y2kblog/DCMotorControlShieldV1_0/Hardware/BasePCB_Image.png

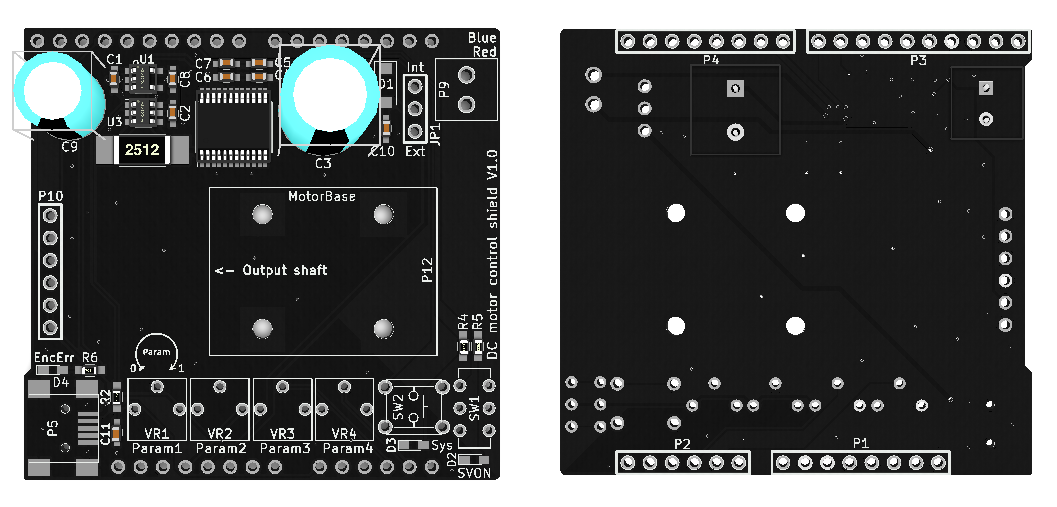
Hardware/BasePCB_Image.png
