y2kblog/DCMotorControlShieldV1_0/Hardware/EncoderPCB_Image.png

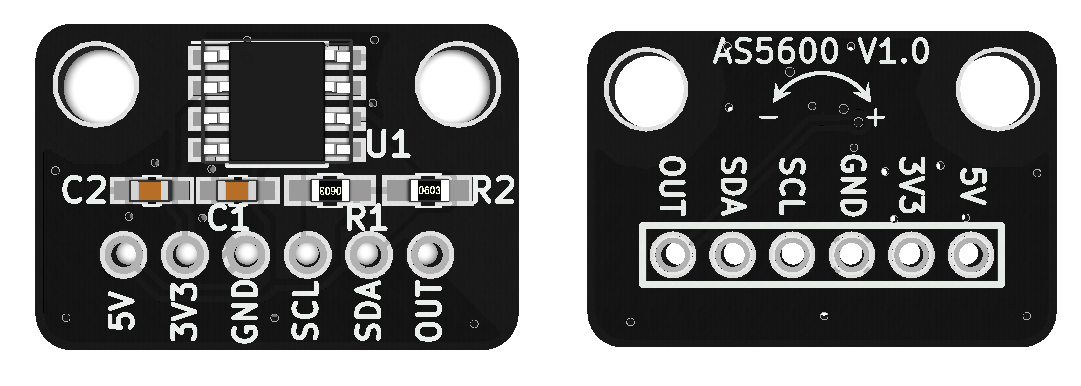
Hardware/EncoderPCB_Image.png
