y2kblog/DCMotorControlShieldV1_0/Hardware/BasePCB_CircuitDiagram.pdf

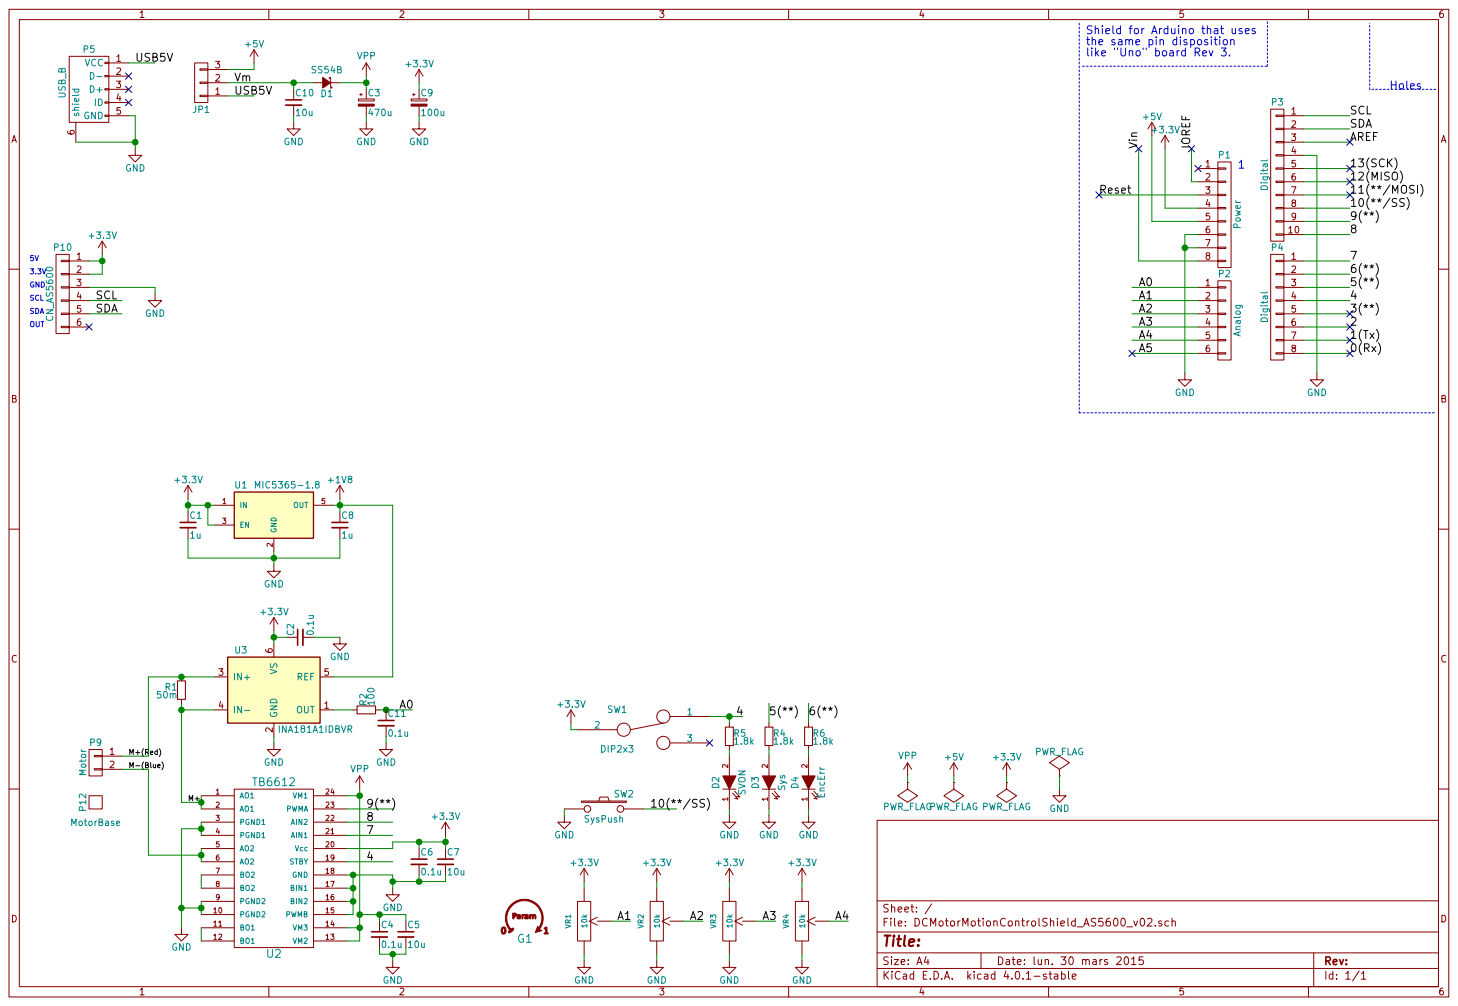
[picture p16: page 1]
