y2kblog/DCMotorControlShieldV1_0/Hardware/EncoderPCB_CircuitDiagram.pdf

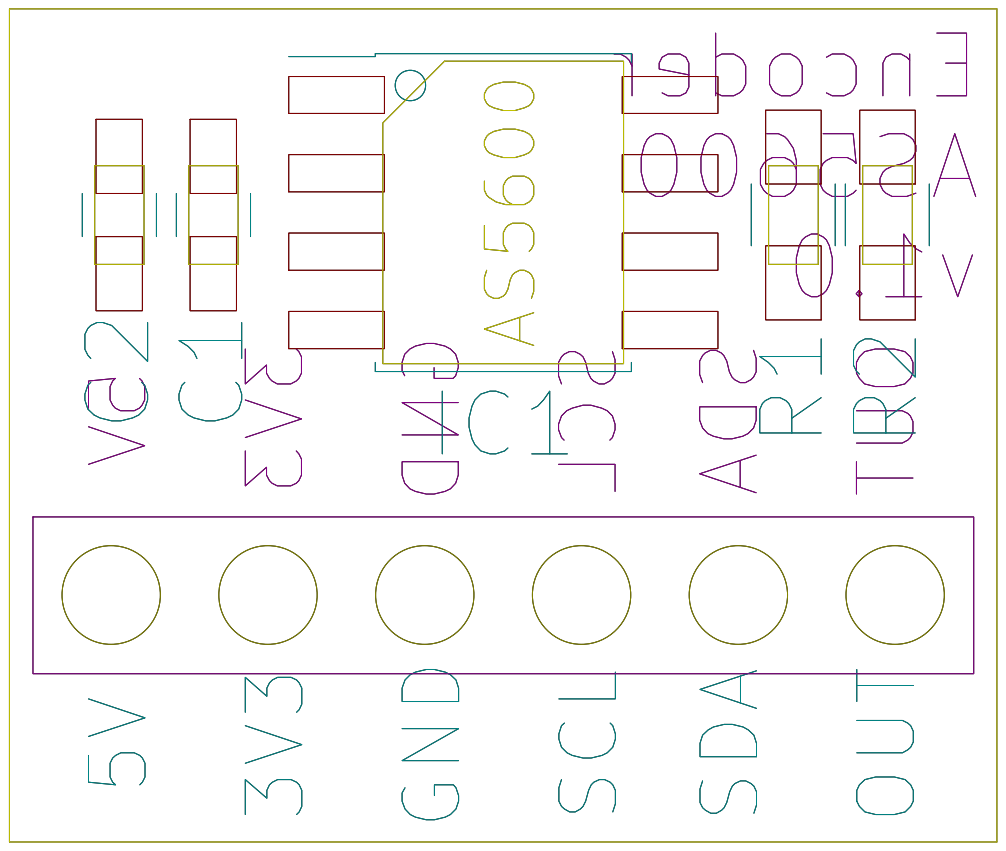
[picture p17: page 1]
