y2kblog/DCMotorControlShieldV1_0/Software/Nucleo-F411RE/DCMotorControlShieldV1_0/DCMotorControlShieldV1_0.ioc

Mcu.UserName=STM32F411RETx
PA0-WKUP.GPIO_Label=Current
PA0-WKUP.Signal=ADCx_IN0
PA1.GPIO_Label=Param1
PA1.Signal=ADCx_IN1
PA13.GPIO_Label=TMS
PA13.Signal=SYS_JTMS-SWDIO
PA14.GPIO_Label=TCK
PA14.Signal=SYS_JTCK-SWCLK
PA2.GPIO_Label=USART_TX
PA2.Signal=USART2_TX
PA3.GPIO_Label=USART_RX
PA3.Signal=USART2_RX
PA4.GPIO_Label=Param2
PA4.Signal=ADCx_IN4
PA5.GPIO_Label=LD2 [Green Led]
PA5.Signal=GPIO_Output
PA8.GPIO_Label=AIN1
PA8.Signal=GPIO_Output
PA9.GPIO_Label=AIN2
PA9.Signal=GPIO_Output
PB0.GPIO_Label=Param3
PB0.Signal=ADCx_IN8
PB10.GPIO_Label=EncErr
PB10.Signal=GPIO_Output
PB4.GPIO_Label=SysLED
PB4.Signal=GPIO_Output
PB5.GPIO_Label=SVON
PB5.Signal=GPIO_Input
PB6.GPIO_Label=SysPush
PB6.Signal=GPIO_Input
PB8.GPIO_Label=I2C_SCL
PB8.Signal=I2C1_SCL
PB9.GPIO_Label=I2C_SDA
PB9.Signal=I2C1_SDA
PC1.GPIO_Label=Param4
PC1.Signal=ADCx_IN11
PC13-ANTI_TAMP.GPIO_Label=B1 [Blue PushButton]
PC13-ANTI_TAMP.Signal=GPXTI13
PC14-OSC32_IN.Signal=RCC_OSC32_IN
PC15-OSC32_OUT.Signal=RCC_OSC32_OUT
PC7.GPIO_Label=PWM
PC7.Signal=S_TIM3_CH2
