y2kblog/DCMotorControlShieldV1_0/(commit log)

2017-09-02 init commit
    [DCMotorControlShieldV1_0 Debug.cfg]
2017-09-04 fix README
    [CPLT_Config.CFG]
